shivamchudasama/PropellerLauncher_3DPrinting/(list of files, cad)

Other CAD files:
Custom_HybridLauncher/Stage1_PropEnd_PIP_0.25.stl
Original_Kocyns/obj_8_cep.stl
Original_LukasHannert/Stage 2 Planetary Carrier.stl
Custom_HybridLauncher/Stage3_HandleEnd_PIP_0.25.stl
Original_Kocyns/obj_1_ruco_rukojet_V5.stl
Original_LukasHannert/Stage 1 Planetary Gear.stl
Custom_HybridLauncher/Stage2_Middle_PIP_0.25.stl
Original_Kocyns/obj_9_Tor_100_toro_mono.stl
Original_LukasHannert/Stage 2 3 Shaft.stl
Custom_HybridLauncher/Stage1_PropEnd_PIP_0.20.stl
Original_Kocyns/obj_6_toro_monoV3_rovne_test5_ruco_vrch_rucoV5.stl
Original_LukasHannert/Lower Housing.stl
Custom_HybridLauncher/Coupon_Clearance_0.20.stl
Original_Kocyns/obj_2_Tor_100_toro_mono.stl
Original_LukasHannert/Upper Internal Toothing.stl
Custom_HybridLauncher/Coupon_Clearance_0.25.stl
Original_Kocyns/obj_3_Tor_150_fin_R1_toro_mono.stl
Custom_HybridLauncher/Handle_B3D.stl
Original_Kocyns/obj_5_ruco_V5_mezikus.stl
Original_LukasHannert/Stage 2 Planetary Gear and Axle.stl
Custom_HybridLauncher/Coupon_Clearance_0.15.stl
Original_Kocyns/obj_7_ruco_V5.stl
Original_LukasHannert/Upper Housing_original_backup.stl
Custom_HybridLauncher/Propeller_Adapter.stl
Original_Kocyns/obj_4_Tor_150_fin_R1_toro_mono.stl
Original_LukasHannert/Upper Housing.stl
Custom_HybridLauncher/Stage2_Middle_PIP_0.20.stl
Original_LukasHannert/67.4mm Propelller.stl
Custom_HybridLauncher/Stage3_HandleEnd_PIP_0.20.stl
Original_LukasHannert/Adapter.stl
Custom_HybridLauncher/Propeller_100mm.stl
Original_LukasHannert/Stage 3 Sun Gear.stl
Original_LukasHannert/Stage 3 Planetary Gear and Axle.stl
Original_LukasHannert/Stage 2 Sun Gear.stl
Original_LukasHannert/Lower Internal Toothing.stl
Original_LukasHannert/Stage 1 Sun Gear.stl
Original_LukasHannert/Output Shaft.stl
Original_LukasHannert/Stage 1 Planetary Carrier.stl
Original_LukasHannert/Stage 3 Planetary Carrier.stl
Original_LukasHannert/Stage 1 Planetary Carrier Top Cap.stl
Original_LukasHannert/Stage 1 2 Shaft.stl
Original_LukasHannert/Lock Nut.stl
Original_LukasHannert/Stage 1 Planetary Bolts.stl
