shivamchudasama/PropellerLauncher_3DPrinting/(commit log)

2026-10-31 Add upstream propeller launcher originals via Git LFS
    STLs from Kocyns and LukasHannert, routed through LFS so the 111 MB
    Stage 2 gear fits under GitHub's file limit. Adds CLAUDE.md and ignores
    local tool config.
    [100mm Propeller.stl, 67.4mm Propelller.stl, Adapter.stl, Lock Nut.stl, Lower Housing.stl, Lower Internal Toothing.stl, Output Shaft.stl, Stage 1 2 Shaft.stl]
2026-10-31 Add hybrid launcher: Kocyns PIP stages with herringbone gears
    Custom_HybridLauncher/ merges the two upstream launchers. Kocyns
    print-in-place stages keep their housing, carriers, bores and 45-degree
    retention cones, with the 15T spur teeth replaced by 18T herringbone
    teeth (Lukas Hannert style, 35-degree helix, 0.20 mm flank clearance).
    The propeller adapter joins the Kocyns hex/collar to the Lukas coned
    spline nose, and the Lukas 100 mm propeller is included unchanged. The
    handle's bottom recess is filled and the B3D Labs logo engraved on it.
    All STLs are generated from the originals by src/build.py; src/check.py
    verifies them (watertight, no fused bodies, gear-mesh sweep, fits) and
    src/as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
    [Coupon_Clearance_0.15.stl, Coupon_Clearance_0.20.stl, Coupon_Clearance_0.25.stl, Handle_B3D.stl, Propeller_100mm.stl, Propeller_Adapter.stl, Stage1_PropEnd_PIP.stl, Stage2_Middle_PIP.stl]
2026-10-31 Add repository README with design preview images
    Root README for GitHub: what the launcher is, what the hybrid design
    takes from each upstream launcher, what to print, how to view the
    animated assembly and regenerate the STLs, the repository layout,
    Git LFS cloning notes and credits. Images in docs/ are rendered from
    the built models (assembly cross-section, stage gear slices).
2026-10-31 Retune hybrid launcher gears to 0.15 mm flank clearance
    The 0.20 mm coupon printed loose and the 0.15 mm coupon turns freely,
    so the default clearance drops to 0.15. Stage STLs and Assembly.glb are
    regenerated; check.py passes with 0 failures.
    [Stage1_PropEnd_PIP.stl, Stage2_Middle_PIP.stl, Stage3_HandleEnd_PIP.stl]
2026-11-01 Loosen hybrid launcher gears to 0.20 mm; add 0.25 mm stage set
    Stages printed at 0.15 mm seized. The 35-degree herringbone flank gap is
    only cos(35) x the per-layer clearance (0.12 mm at 0.15), tighter than any
    gap in the Kocyns original (planet-ring 0.16 mm, sun-planet 0.22 mm).
    - CLEARANCE default 0.20 (0.163 mm true flank gap)
    - stage STLs now carry their clearance: Stage*_PIP_0.20.stl (default)
    and an alternative Stage*_PIP_0.25.stl set (0.205 mm true gap)
    - build.py stage_file() names them; check.py verifies every set present
    - Assembly.glb regenerated; READMEs and CLAUDE.md updated
    Handle, adapter, propeller and coupons are unchanged.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
    [Stage1_PropEnd_PIP.stl, Stage1_PropEnd_PIP_0.20.stl, Stage1_PropEnd_PIP_0.25.stl, Stage2_Middle_PIP.stl, Stage2_Middle_PIP_0.20.stl, Stage2_Middle_PIP_0.25.stl, Stage3_HandleEnd_PIP.stl, Stage3_HandleEnd_PIP_0.20.stl]
